alexthecat123/ArduinoFile/(threads)

Thread 1 (2023-01-06):

New build, getting a variety of errors - 84 & 75

mg-man, 2023-01-06:
Hiya, I've just built a couple of these - awesome project btw! - and seem to be running into various issues.  I've re-formatted my uSD card a few times, using both Windoze and also the SD Formatter tool.  Unfortunately, when initially trying it with the SDTemplate files, I get an 84 error - which I believe is boot blocks corruption?  When I put the uSD in my computer and overwrite the profile.image with the selector.image, the Lisa tries to boot, but then throws a "75" error - which I believe is OS files corruption?

I'm going to try some other uSD cards and also a different power setup today, but logging this here to see if it rings any bells.  I'll add more observations along the way.

mg-man, 2023-01-06:
So... switched to another PDU, another uSD card, still getting the "84" error on power-on.  Here's what's happening in the log :

`Switching to the 5MB ProFile spare table.
ArduinoFile is ready!
Phase 1: Host didn't respond with a 55! Maybe the drive was reset?
Phase 1: Host didn't respond with a 55! Maybe the drive was reset?
FFFFFF0A0000
Bad Command!
FFFFFF0A0000
4

FFFFFF0A0000
Bad Command!
FFFFFF0A0000
4

Switching to the 5MB ProFile spare table.
ArduinoFile is ready!
Resetting drive...`

The FFFF sections were spat out when booted from the Lisa OS diskette 1 and choosing [Install].  They were spat out during the 'Looking for HD' phase - which ultimately failed with 'No HD found'.

The last "Switching to" was after hitting RESET while everything powered up.  Attempt to boot gave me "84".  I then powered the Lisa off - which gave the 'Resetting drive...'

Lastly, mine is a Lisa 2/10 and works perfectly with a IDEfile on the internal connector, which I'm attempting to connect the ArduinoFile to. It also works with a real ProFile on the parallel card.

alexthecat123, 2023-01-07:
So it looks like the issue here is that the Arduino just isn't fast enough to keep up with the VIAs on the 2/10 since they're clocked faster than those on the 2/5. I'm already pushing the Arduino to its limit on the 2/5 and I guess this is just too much for it to handle. I've known about this problem for a few months now and I thought that I updated the readme to let people know before they build one, but it looks like I never updated it. I'm really sorry about this and I've updated the readme now! And of course, feel free to mess around with the sections of the code that deal with reading /STRB pulses and reading or writing the corresponding data on the bus to see if you can optimise it any more than I could. I'm not a professional software developer or anything, so there's almost certainly some more optimizations that can be done!

mg-man, 2023-01-07:
Thanks for getting back... but that is a really bummer!  I suppose the upside is it saves me wasting too much time trying to make it work.  I was kind of surprised to be the first to open an issue, so I guess there aren't too many of these out in the wild?

Please don't feel too bad, all is not lost... I'm actually working with a friend on restoring about 6 Lisas.  Only one is a 2/10 like mine, the rest are 2/5s.  Question on the 2/10, is it only when using the internal "Widget" connector that we run into this?  I do have a Parallel Card I can try... (hmm... given the time difference between us, I might have the answer as I'm going to try)  I've already build up 2 shields and have parts for a few more, so can do some experimenting and report back.

As for tweaking the code.... while I have s/w engineering skills, they're pretty dated - ASM86, Fortran [77!], Pascal, etc... I have dabbled in some PHP and Python, but only enough to be dangerous!  Do you think it'd be worth mentioning on LisaList to see if anyone out there wants to have a crack at it?

Lastly, I have poked around the 'web to see if there's a "faster" Mega 2560.  I've found the Arduino Due, but that seems limited to 3.3V output - which probably won't work?  I've also seen mention of the Hitex ShieldBuddyTC275, but that looks pricey and appears to use a different tool chain?  And, then there's the Adafruit Grand Central M4 Express... but that too is 3.3V logic.  Any thoughts?

mg-man, 2023-01-07:
Another thought... I found mention of changing the clock crystal to 20Mhz, along with MCUdude's https://github.com/MCUdude/MegaCore...  Question, assuming I manage to do this, is it likely to work or do you have timing loops that assume the standard 16Mhz clock?

alexthecat123, 2023-01-07:
Yeah, I don't think very many people have made one of these out in the wild; there's only one other person that I know of besides you who's actually built one.

Good luck with your Lisa restoration project; six Lisas is a lot to work with! Unfortunately, I just tested the device with a parallel card and it doesn't work there either because the parallel card VIAs are clocked faster than those 2/5 I/O board as well.

I thought about using the Due or another 3.3V Arduino-compatible board, but the 3.3V logic issue makes that a little bit complicated. My goal with this project was to make everything as cheap and simple as possible and the addition of an expensive Due and the complexity of level shifters (many of which are SMD components, which I would prefer to avoid) make the project stray away from this goal. If worst comes to worst, I might try to switch to a Due or something, but it would definitely be less than optimal.

The 20MHz overclock sounds like a really good idea! I'm not sure if it'll be enough to fix things, but it's definitely worth a try! There aren't any timing loops in the code that are tied to a particular clock frequency, so things should work without any modifications after switching to the new crystal.

I'm about to go back to college for the spring semester, so I probably won't have much time to work on any of this for a little while, but feel free to give it a try yourself and see what happens!

mg-man, 2023-01-07:
> _I just tested the device with a parallel card and it doesn't work there either_

Darn it!

> _I thought about using the Due ... but the 3.3V logic issue makes that a little bit complicated._

Yeah... I suspected that.

> _The 20MHz overclock sounds like a really good idea! ... There aren't any timing loops in the code that are tied to a particular clock frequency_

Good to know.  I might try this.  I have 3 x Megas, so I can use one as a "test subject".

Good luck with College.  I'll let you know how I get on.

mg-man, 2023-01-18:
SO... an update.  After a few failed attempts at using a faster ceramic resonator, I've managed to over-clock my Mega using a discrete crystal + 22pF caps...

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

Used CoreMark [https://github.com/PaulStoffregen/CoreMark](url) to confirm the 25% bump.  :-)

Unfortunately... I still haven't gotten it working.  Here's the log (I added the "/*" remarks) from a couple of tries :

`First attempt
--------------------------------------------------------------------
/* power on ArduinoFILE
Switching to the 10MB ProFile spare table.
ArduinoFile is ready!
/* power on Lisa
Phase 1: Host didn't respond with a 55! Maybe the drive was reset?
/* Lisa tries to boot
Phase 1: Host didn't respond with a 55! Maybe the drive was reset?
00000A000000
/* press Opt-3, Opt-1 to boot from internal drive
Phase 1: Host didn't respond with a 55! Maybe the drive was reset?
Phase 1: Host didn't respond with a 55! Maybe the drive was reset?
00000A000000
/* power off Lisa
Resetting drive...

Second attempt
--------------------------------------------------------------------
/* Lisa powered-on, hit reset on ArduinoFILE
Switching to the 10MB ProFile spare table.
ArduinoFile is ready!
/* hit Opt-3 to get to Lisa boot menu
Phase 1: Host didn't respond with a 55! Maybe the drive was reset?
/* hit reset on ArduinoFILE
Switching to the 10MB ProFile spare table.
ArduinoFile is ready!
/* hit Opt-1 to boot from internal drive
Phase 1: Host didn't respond with a 55! Maybe the drive was reset?
00000A000000
`
As you can see, I'm still getting the "55" error, but what's spat out after is different.  I'm now getting a "00000A000000" whereas before I was getting "FFFFFF0A0000".

Any thoughts?

mg-man, 2023-01-18:
> So it looks like the issue here is that the Arduino just isn't fast enough to keep up with the VIAs on the 2/10 since they're clocked faster

Out of curiosity... _how_ much faster are they clocked?

alexthecat123, 2023-01-18:
Sorry to hear that things still aren't working! The "host didn't repsond with a 55" error isn't really an error in this situation, so we can pretty much just ignore it. The Lisa checks for a ProFile's presence when you enter the boot menu by starting (but not finishing) the handshake and it does the same thing again when you actually tell it to boot from the drive, hence these errors saying that the Lisa never responded with a 55 to complete the handshake. Those errors would be problematic if you were getting them all the time after successfully starting the boot process, but they're to be expected here.

Unfortunately, I don't think that the change from FFFFFF to 000000 really means too much. It seems to show that the ArduinoFile is running a little faster and reading different incorrect data now, but it's definitely still reading an incorrect command. The "0A" byte should be the second to last byte in the command, but it's third to last instead, so the ArduinoFile is definitely still missing some stobe pulses. As far as I know, we can't overclock the ATmega2560 any more than this, so we're kind of stuck. The only options are switching to a faster (and preferably still 5V-tolerant so that we don't have to add level shifters) MCU or optimizing the code to make sure that we read all of the strobe pulses. I spent hours and hours on that section of the code when first creating this thing, so I'm not sure how much more optimized we could make it. I think I also configured the ATmega at some point to send us an interrupt on each strobe pulse so that we don't have to keep polling the strobe, but this was slower than the current solution from what I remember. Maybe I could try rewriting it in assembly or something? I think that's the only thing I haven't tried yet!

The VIAs in the 2/5 are clocked at around 500kHz, while the VIAs in the 2/10 are clocked at 1.25MHz. So it's a pretty significant difference!

mg-man, 2023-01-18:
> The VIAs in the 2/5 are clocked at around 500kHz, while the VIAs in the 2/10 are clocked at 1.25MHz. So it's a pretty significant difference!

Yah, it is!  More than a 25% speed bump is gonna compensate for.  :-(

This may be a complete red herring... but when Googl'ing how the PINL command works, I found this reference to the way it behaves on the Mega ...
[https://forum.arduino.cc/t/arduino-coding-without-delays-using-program-ticks/196693/17](url)

alexthecat123, 2023-01-20:
That's really interesting! I had no idea that some of the I/O registers required more CPU time to access than others! I wonder if it's a big enough difference to solve our problem? I'm super busy with college right now (this semester has been the busiest one so far), so I'm not sure when I'll get around to switching to different ports and trying things again, but I'll definitely let you know if/when I get around to it! And of course, feel free to give it a shot yourself if you're in a hurry to get things working!

mg-man, 2023-01-20:
I'm glad that wasn't a total herring!!  Unfortunately, I'm not sure I have the knowledge / skill to investigate a change.  :-(  Will switching to a different port be purely software, or would hardware mods be needed?  If software, I'm willing to have a crack if you'll point me in the right direction.  ;-)

There's no massive rush, it'd just be nice to have a solid-state alternative to my failed Widget.  Get back to me when you can and good luck with college!

alexthecat123, 2023-01-20:
Sadly, it's a little more than just software. The ports are implemented in hardware, so a certain set of 8 Arduino pins connect to each port. Changing the port would require rewiring the data bus to a different set of pins that correspond to another port. The software side is really easy, though. Let's say that we're going to change the bus from port L to port A. All we would have to do is replace all instances of PORTL with PORTA, PINL with PINA, and DDRL with DDRA. The port for the control signals is already one of the "fast" ports (port C), so we can just leave that one alone! Looking at the ATmega2560 datasheet, it seems that all ports under address 0x60 (meaning ports A-G) can be accessed quickly, so changing to any of these (other than C since it's already used) would be fine.

mg-man, 2023-01-20:
> Sadly, it's a little more than just software.
Darn it!!  ...but I kinda figured.

> Changing the port would require rewiring the data bus to a different set of pins that correspond to another port.
So that's 8 x "cuts" and 8 x "bodge wires"?  Won't be pretty, but doesn't seem impossible.  I had 5 x 'boards made up, and have so far only built up 2, so I'm happy to hack at one of them if you can point me in the right direction?  Do you want to create a Lisa 2/10 branch and we'll get started?

alexthecat123, 2023-01-21:
I just created a 2/10 branch and added you as a contributer so that you can update things with any changes that you might make. And yep, it's 8 cuts and 8 bodges. Not super fun, but it could definitely be way worse (flashbacks to the 70 or so bodges that I had to do on my VERY damaged 2/5 I/O board)! Thanks for offering to give these mods a shot; I've been really stressed with school and this defintely relieves some of that stress!

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

There's an image showing you the different ports on the Arduino Mega. You can probably see why I went with ports C and L; all of the pins for the port are clustered together instead of being scattered all over the place! I'm not sure why I went with C and L instead of C and A, but we can't use A anymore because that's where I hooked up the status LED and it would be easier if we didn't have to mess with that. Looking at the image, it seems like port B or F would be the way to go; the other ports are either in that extended I/O space that slows down access or not all of their pins are exposed on the Arduino. B would probably be the best choice since keeping F free would be nice in case we ever decide to use analog inputs or outputs in the future, but it's totally up to you! Let me know which port you choose and I'll go through and change the code accordingly so that you can focus more on the hardware.

Rewiring everything should be pretty simple; tedious but simple. Just connect PD0 to pin 0 of the port, PD1 to pin 1 of the port, and so on up to PD7.

When cutting the traces, make sure to cut them between the Arduino and LS280 parity generator, not between the parity generator and the 26-pin ProFile connector! We need to keep the LS280 connected to the data bus, and cutting it out of the circuit would screw things up. From what I remember when I first made this thing a year ago, MacWorks would still work since it doesn't care about parity, but LOS would not be happy!

mg-man, 2023-01-21:
> I just created a 2/10 branch and added you as a contributer so that you can update things with any changes that you might make.

Cool, thanks!

> Thanks for offering to give these mods a shot; I've been really stressed with school and this defintely relieves some of that stress!

Well don't stress about this!!!  I have a pretty demanding job, so I have to dip in and out of this as well.  If I sound a little annoyed at times, it's a) probably work-related ;-) or b) just really wanting to figure out how to make this to work.  I could not have possibly done what you've done myself, so I'm grateful you did and eager to see if we can created a 2/10 compatible implementation!  :-)

> There's an image showing you the different ports on the Arduino Mega.

Thanks for that!  I did a bit of Googl'ing, but always landed on much more complicated diagrams - this one is much clearer for what we need (find another - hopefully faster - port).

> we can't use A anymore because that's where I hooked up the status LED

Glad you said that.  On the 'complicated' ones I did find, I compared them to my boards and it did look like Port A was in use (and connected to the LEDs), so I was a little confused given your initial comment about Port A vs L above.  This clears it up and also confirms I'm looking at the right things on my board.  :-)  If we DO get this working, maybe you can move the LED control to Port D for example - which appears to be in proximity to the LED placement, meaning A could be re-purposed.  Maybe that will make the routing simpler like it was for Port L?  Let's see if I can get it working first tho.  :-)

> Let me know which port you choose

Will do.  I'll work out where the connections to Port L come and go and then which alternate Port to aim for.  Tell me something, though... looking at the image above, I can only see 5 pins for Ports D & E, 4 pins for Port G?  Am I reading this correctly?  If so (and assuming we need 8 pins = byte-wide), that means our choices are B or F only.  I'll go for B as you suggested, but let me know if I have this right.

> When cutting the traces, make sure to cut them between the Arduino and LS280 parity generator

Hee, hee... I did spot some were going to the LS280, so wondered about that - thanks for the clarity!

It might be a day or three before I get stuck into this, so focus on your studies and enjoy the weekend!

mg-man, 2023-01-21:
> Just connect PD0 to pin 0 of the port, PD1 to pin 1 of the port, and so on

SO... re-reading this.  Am I correct that all I need to do is locate the traces that go from PDx to Port L and sever / replace those?  If so, I didn't solder in the Debug Header, so this might not end up too ugly of a bodge!  LMK

mg-man, 2023-01-22:
> B would probably be the best choice since keeping F free would be nice in case we ever decide to use analog inputs or outputs in the future

Well... I sat down to have a look at this and discovered an issue with using Port B.  From looking at the board (and schematic) it looks like a few of the pins on Port B are used for the uSD card adapter.  :-/  Can you confirm?

As for Port F, it's marked as "ANALOG IN" but you mention it above, so it _can_ be used for 'digital' (logic) as well?

Lastly... I've realised I can modify one of my boards without making ANY cuts.  All I need to do is omit pins 42 - 49 of the header, and then wire PD0 - PD7 to the Port F pins - right?

alexthecat123, 2023-01-22:
To answer your question about certain ports only having a couple pins, it's because they didn't wire every pin on the ATmega2560 to a pin on the Arduino. I'm not sure why they did this (maybe they didn't have enough space to do all of them), but this is why some of the ports only have a few of their pins exposed.

Darn, you're totally correct about the SD card! Clearly I didn't look at the schematic very closely, lol. So I guess port F is our only option. And yeah, the analog pins can be used as both analog and digital pins, so we should be good to go there!

And that's a really clever way of rewiring things! I didn't even think of that as a possibility, but it's definitely the smartest way to do this! Just make sure that PD0 goes to pin 0 of the port, PD1 goes to pin 1 of the port, and so on. Otherwise, we would have to do some painful modifications to the code that would probably slow things down to the point that it wouldn't even work on the 2/5!

I changed the code in the 2/10 branch to reflect the change to port F, so you can just upload that to the Arduino whenever you're ready to test things!

Good luck and let me know how it goes!

mg-man, 2023-01-22:
Thanks for getting back on all that.  Glad I'm able to make some sense of this.  😀  I'd already decided to embark on using PORTF.

After a false start which ended up being a bad microSD adapter, I managed to get the modded on built.  Here are some pics:

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

Moment of truth... attached it to a standard Mega, got the 84... drat!!  So... tried it with my go-faster Mega... and...

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

Woo woo!!!  But... I'm not sure why it isn't seeing any of the images I have on the SD card - there are two, and I know they work on my IDEFile and one of ArcaneByte's BeagleBoard-based ProFile emulators.  Any ideas?

alexthecat123, 2023-01-22:
WHAT? It actually worked? I honestly wasn't expecting that, but that's so awesome! Great work! As for the error message that you're seeing there, I get that occasionally too, even when using a real Cameo/Aphid. I have no idea what causes it, but you should be able to get past it by choosing the B(oot option. If that doesn't work, try the S(tart over option, and if that still doesn't work, try Q(uitting to ROM and then booting from the ArduinoFile again.

It's definitely able to read the contents of the SD card because the emulator would halt itself and turn the LED red if it didn't detect an SD card. Also, you wouldn't be seeing that message if it wasn't able to boot from the Selector image, so I'm pretty confident that there isn't anything seriously wrong and that following the instructions above will fix things!

It kind of sucks that the overclock is still necessary to get things working, but at least it isn't a particularly difficult mod or anything. And the mod only needs to be done if you're using a 2/10, which seems to be a minority compared to 2/5 users, so I guess it's not too bad!

By the way, those are some really nice and clean bodge wires! And I love the black color of your board too; I'll definitely be ordering my next batch of boards in black!

mg-man, 2023-01-22:
> WHAT? It actually worked?

Well.... not quite it seems.  I did try S)tart and B)oot but it kept coming back to the same screen.  I then decided to just rename one of my LOS images to be profile.image - and it started to boot... then emitted a medium tone and threw be back to the Startup From... screen (with the tone still on).  I tried another boot and this time it cleared the tone, but crapped out with a 10707 error.

I then decided to try and Repair the HD... no joy.  So I then tried to just Install LOS.  It 'sees' the HD and asked if I wanted to Erase, so I did.  After a L O N G wait (with the Status LED flickering away) it barfed with the following :

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

I didn't have my laptop connected to the serial output, so tried another Erase - here's the top and tail of the log :

/* Lisa powered-on, hit reset on ArduinoFILE

Switching to the 10MB ProFile spare table.
ArduinoFile is ready!

/* Booted from LOS Install Disk 1 and chose "Install"

Phase 1: Host didn't respond with a 55! Maybe the drive was reset?
Phase 1: Host didn't respond with a 55! Maybe the drive was reset?
Phase 1: Host didn't respond with a 55! Maybe the drive was reset?
000000000A03
00FFFFFF0A03
0000000D0A03
000000020A03
000000070A03
0000000C0A03
000000010A03
000000060A03
0000000B0A03

------

0100002D0A03
010000220A03
010000270A03
00FFFFFF0A00
0000002E0A03
0000002E0A03
0000002E0A03
0000002E0A03
0000002E0A03

So, as they say, "close, but no cigar"

Been a long day... I might try with a 5Mb ProFile image tomorrow.  Also... I have some 74HCT280s on order - just to try.

Let me know if there's anything else you can think of.

alexthecat123, 2023-01-23:
Well darn. Never celebrate too early I guess. That output is identical to what I get when I do an install on a 2/5, so it looks like it's receiving all of the command bytes properly now. I remember LOS being very picky about timings when I was first designing this thing; believe it or not, MacWorks worked fine on the very first test I ever did, but the Office System took a couple weeks of work to figure out. I wish I remembered exactly what timings it was unhappy with....

To go any further, we probably need to look at a logic analyzer trace. I'm not sure if you have a logic analyzer, so this might be the point where I need to just build the updated version and mess around with it myself. I'll try to design an updated PCB (and clean up that monstrosity of a schematic that I drew when I was still new to PCB design) as soon as I can and then I'll see if I can figure things out. Unless, of course, you have a logic analyzer and want to try it yourself. I wish I wasn't so darn busy with school right now!

I doubt that the HCT280s will fix things since the original ProFiles themselves used LS280s, but it's definitely worth a shot! I also didn't think that switching to port F would make this much of a difference though, so what do I know?

Maybe give it a shot with MacWorks and see what happens there. If it works okay, then that sort of confirms our theory that it's a LOS-specific issue.

mg-man, 2023-01-23:
> Well darn. Never celebrate too early I guess.

Yeah... but I consider a step forward.  Small victory, but the war is still to be won.  😀

> That output is identical to what I get when I do an install on a 2/5

Interesting... including the Stop Sign fail?  Maybe you're on the edge with timing on the 2/5, and I'm now getting to the same point with the 2/10?  🤔  In addition to the HCT280s, I'm debating on boosting another of my 2560s to 22.1184 MHz - which is a better match for serial port speed conversion.  It will mean I need to build my own bootloader - or use a USBasp (which I'd need to get), hence the debating...

Something else I found that may be worth a go is this - https://forum.arduino.cc/t/digitalwritefast-digitalreadfast-pinmodefast-etc/47037 - any thoughts?

> To go any further, we probably need to look at a logic analyzer trace

Yeah... I figured we might be on that path.  Sadly, I don't have one.  It's also a shame we're on opposite sides of the ocean - making sending you one of my boards cost-prohibitive.  😞

Thanks for sharing your experiences, it sounds like we're heading in the right direction and maybe some of the above will get us there.  I'll start with the HCT280s, then attempt another clock boost, and will give MacWorks a spin.  LMK what you think about those DigitalFast routines.

alexthecat123, 2023-01-23:
> Yeah... but I consider a step forward. Small victory, but the war is still to be won. 😀
I guess you're right! It's definitely working better than it was, so we're taking some steps in the right direction!

When I said that I got the same output on the 2/5, I was referring to the ArduinoFile debug stuff over serial, not the error message. It would've been really bad if I got that error message on the 2/5 as well! What I was trying to say is that it's clear that we're properly receiving the command bytes now because they perfectly match the command bytes from a successful install on my 2/5.

I had no idea that you could overclock the Mega past 20 MHz, so it'll be really neat to see what happens if you bump the clock speed up a little bit higher! Assuming it's not too much of a pain for you, I'd say go for it! We're clearly pretty close to getting it to work and that additional 2 MHz might be enough to do it!

I just took a look at that forum post and unfortunately that won't really help us here. That library is basically providing a wrapper over direct port manipulation that's way faster than the default digitalRead and digitalWrite, but still slower than direct port manipulation. But unfortunately we're already manipulating the ports directly. That's what all of the weird code like "PORTF = 00001111" is for; we're directly writing values to the port registers to maximize speed instead of using more programmer-friendly functions like digitalWrite or the digitalWriteFast that you linked to. Plus, writing an entire byte to the parallel bus is much quicker and easier with direct port manipulation since you can set all 8 bits with one line of code instead of having to do a bunch of digitalWrites in a row. So good idea, but unfortunately it would slow things down.

Since you don't have a logic analyzer, I'll just design some new boards and get them ordered as soon as I have time. I would just modify one of my existing ones, but it's probably better to go ahead and order some with the new design. I'll have to do a redesign eventually, so might as well go ahead and do it now!

Good luck with the HCT280, clock speed, and MacWorks experimentation!

mg-man, 2023-01-24:
> When I said that I got the same output on the 2/5, I was referring to the ArduinoFile debug stuff

Thanks for clarifying. So you "have" been able to Erase/Install LOS, goos to know it _should_ work.

> So good idea, but unfortunately it would slow things down.

No worries... I'm pretty sure I spotted at least one DigitalWrite in the code, but no DigitalReads.  On further inspection, looks like you're only using it in the setup section and for the LED.

> I had no idea that you could overclock the Mega past 20 MHz

😀  When researching this... I saw mention of ppl claiming 30Mhz works!  I'll try 22.1184  since I do
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

Thread 2 (2023-10-24):

R/W errors in MacWorks and error 1070 in LisaOS

RolandJuno, 2023-10-24:
Background: I have a Lisa 2/5 system that consists of a original CPU and SunRem 2MB cards as well as reproduction motherboard and I/O cards. I'm also using EPROMs as emulated PROMs on the CPU and I/O cards as well as a COP emulator on the I/O card.

Reads from the ArduinoFile seem solid. I've not encountered issues there. The issue seems to be with writes to the device. The symptoms while using the ArduinoFile are:

- MacWorks will report **"The file "name" couldn't be written and was skipped (disk error)."** while copying a large-ish file (one that typically takes multiple read/write cycles in the Finder).
- When I try to boot into the LisaOS, I get an error 10707.

First I tried the following:

- Monitored the serial port for debug messages. When the error in MacWorks appeared, the debug statement **"Phase 1: Host didn't respond with a 55! Maybe the drive was reset?"** appeared.
- Set the timeout value from 10000 to 20000. MacWorks still produced the error but there was no error messages on serial this time.
- Changed the version of SDfat to an earlier version (2.0.5 is pictured in the docs but that wouldn't compile. 2.1.0 was the oldest that would compile).
- Removing the Serial.println statements in an attempt to speed things up

I then found this issue thread which seemed to offer some hope! I tried the following:

- Set the compiler flag to -Ofast.
- Bodged the board to use PORTF instead of PORTL.

None of these so far has resolved the issue in MacWorks. I'm hoping that someone has some ideas of what might be the issue?

Update: I enabled many of the serial debug statements in the code and watched the stream. It seems the Mac will write data and then read it back to verify. I got a new error this time.

- Timeout: Read Command Confirmation
- Phase 1: Host didn't respond with a 55! Maybe the drive was reset?

PS Alex, I know you're very busy so reply only if time allows! Your university studies should be your top priority! =-)

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

_Originally posted by @RolandJuno in https://github.com/alexthecat123/ArduinoFile/issues/1#issuecomment-1777440929_

RolandJuno, 2023-10-24:
I'm using the fork located at https://github.com/alexthecat123/ArduinoFile/tree/2/10-Testing

The CPU card is an original. Unfortunately, I don't have access to any other I/O cards. I'm using H ROMs on the CPU card.

The quartz clock on the CPU card are original. The ones on the I/O board are to spec.

I have been curious about the 6522 as being suspect. I have some extras I can try plus the modern WDC W65C22N6TPG (which I couldn't get to work originally but are supposedly drop-in replacements for the original 6522). Will give this a try.

I've tried three different class 10 SD cards (SanDisk, Samsung and PNY).

Also, as before, I increased the timeout value to 15000 this time and both errors in the serial debug stream went away but the error on MW II+ still persist (but definitely seem to be related to reading back what was just written).

Is there a way to write to the debug stream the actual data in HEX that is being read and written? That could help me pinpoint if it's an actual verify error or a timing error.

RolandJuno, 2023-10-24:
I just tried three different 6522 chips in U5C. A SY6522A, MOS6522, and a new W65C22N6TPG. All three produce errors from the ArduinoFile.

`Timeout: Write Command Second Handshake Part 2
Phase 1: Host didn't respond with a 55! Maybe the drive was reset?

Timeout: Read Command Confirmation
Phase 1: Host didn't respond with a 55! Maybe the drive was reset?

Timeout: Write Command Confirmation
Phase 1: Host didn't respond with a 55! Maybe the drive was reset?
`

Does this seem to show that we're missing a signal (or never get one)?

RolandJuno, 2023-10-24:
I connected my logic analyzer to the pins pictured in the screenshot (6 control lines and 2 data lines). I attempted to copy a large application in MW II+. It produced a write error on the Mac side. The last few lines of the debug from the ArduinoFile are:

..
010034F7030A
010034FC030A
010034F1030A
010034F6030A
010034FB030A
01003500030A
01003505030A
0100350A030A
0100350F030A
01003504030A
01003509030A
Timeout: Write Command Confirmation
Phase 1: Host didn't respond with a 55! Maybe the drive was reset?

The logic analyzer was stopped shortly thereafter with this near the end of the capture.
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

Zooming in:
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

Hopefully this helps? Let me know if you want the raw data or more screenshots or measurements.

mg-man, 2023-10-24:
> _I'm using H ROMs on the CPU card._

Can you use H ROMs on a 2/5 I/O board?  I thought H ROMs were for the 2/10?

RolandJuno, 2023-10-24:
Yes, H it works with a 2/5 system. H/A8 is the combination I have.

> Common/Recommended combinations:
>
>    H/A8 - Typical for a Lisa 2 or 2/5

Source: https://lisafaq.sunder.net/lisafaq-hw-rom_versions.html

mg-man, 2023-10-24:
Fair enough, I knew there was a diff between the 2/5 & 2/10... but that's the A8 vs 88 - mine's [2/10] the latter.

RolandJuno, 2023-10-24:
I get further in the MW II+ copy by changing timeout in ArduinoFile to uint32_t and increasing it x10 to 100000. It seems to fail at the end with a "disk error" now rather than a write error.

I decided to run Disk First Aid and it reports it's not an HFS disk. ArduinoFile produces an error:

> 0000FFE1030A
> Error: Requested block is out of range!
> 0000018C030A

Maybe that's expected behavior? @mg-man Can you successfully use Disk First Aid with your ArduinoFile?

mg-man, 2023-10-24:
I'm the one who started the Issue #1 thread, and tried over-clocking my Mega and also the Port F mod.  I was never able to get my ArduinoFile to fully boot as my Lisa is a 2/10.  I've not had a chance to try these latest mods, but am excited to do so.  Will have to wait, though, on vacation with family atm.

RolandJuno, 2023-10-24:
Your detailed posts and tenacity are what drove me to dive deeper into this issue I'm having-- thank you for that! Enjoy your holiday!

mg-man, 2023-10-24:
Thx.  I'm pretty excited to try @i-to-z's compile flag as soon as I can find some time. I'm also restoring a 2/5 which I want one of these for as well!

mg-man, 2023-10-24:
Out of curiosity, have you tried another LS280?

RolandJuno, 2023-10-24:
Lots of progress just made. I noticed that when I gave it a really long timeout, the second error "Phase 1: Host didn't respond with a 55! Maybe the drive was reset?" didn't appear anymore. Additionally, the system wouldn't boot properly into the drive selector mode for aphid/cameo (it just hung and the green light never came on).

I decided to keep timeout at 10x (100,000). I created a secondary timeout for all those loops called phaseTimeout and set it to the original (10,000).

> uint16_t phaseTimeout = 10000; //around 18ms
> uint32_t timeout = 100000;
...
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

I also decided to start from scratch. I created a new harddrive image and booted from a MW II+ floppy. I chose the internal Profile in the installer and clicked install. It began by formatting the drive. The ArduinoFile began reporting sequential block writes as expected. I also noticed this took **a lot longer** than it did in previous attempts (I wasn't monitoring the serial debug stream at that point however so it very well could have had an error there).

Curiously, when it got to block 80000, it began reporting "Error: Request block out of range!"

```
...
01007FF2030A
01007FF7030A
01007FFC030A
01007FF1030A
01007FF6030A
01007FFB030A
01008000030A
Error: Requested block is out of range!
01008005030A
Error: Requested block is out of range!
0100800A030A
Error: Requested block is out of range!
0100800F030A
Error: Requested block is out of range!
01008004030A
...
```

Despite this I let it roll. It eventually successfully installed everything. First real test was to copy a System Folder over to it, which worked the first time. I rebooted and proceeded to install System 6.0.8 which worked without issue. I rebooted and copied over Photoshop 1.0 which also worked!

So far, that may have solved the issue! I'll continue testing to be sure and will report here.

i-to-z, 2023-10-25:
[RolandJuno](https://github.com/RolandJuno),
I haven't tried running MacWorks+ on a Lisa. I want to try it too.
Which of the many versions listed here are you using?
https://www.macintoshrepository.org/apple-lisa/software_search.php?s=macworks

Also: have you tried less-demanding operating systems on your Lisa, like MacWorksXL3.0 ? Since it works well for most of us, it may be a good validation for you that your hardware is solid.

Regarding the "Error: Requested block is out of range!" error: Perhaps you should try installing MW+ on a larger blank image file?

RolandJuno, 2023-10-25:
Thanks for the reply! I chose a disk image size of 32MB which I believe is supported with MacWorks. I hope that the installer was able to read the size of the disk before attempting to format it.

In any case, the ArduinoFile now has been working flawlessly all night. I've been installing a lot of software and docs on it without a single disk read/write error. It's amazing that AppleTalk works with it too-- I'm able to connect to my RaspberryPi running MacIPGW via a EtherTalk to LocalTalk adapter.

Tomorrow I hope to try the LisaOS again to see if it clears up the 10707 error I was getting.

jake18125, 2023-10-25:
@RolandJuno That's brilliant! Do you think that fix would work with a stock ArduinoFile without the PORTF mod?

Also any chance you could share the complete .ino file? Thanks!

Thread 4 (2023-11-26):

SD card footprint mirrored?

RolandJuno, 2023-11-26:
I ordered some boards of the ArduinoFile 1.1 gerbers (labeled v4 on the schematic-- with P0-7 pins mapped to A0-A7) and noticed the SD card pinout might be reversed from the original. The SD card reader needs to be installed up sidedown.

Edit: I also think the pin mapping for the LED needs to be changed as below.

```
const int red = 41; // was 22
const int green = 40; // was 23
const int blue = 39;  // 24
```

```
  //pinMode(22, OUTPUT); // old pin assignments
  //pinMode(23, OUTPUT);
  //pinMode(24, OUTPUT);
  pinMode(red, OUTPUT); // new pin assignments
  pinMode(green, OUTPUT);
  pinMode(blue, OUTPUT);
```

With these changes, the ArduinoFile boards seem to be functional! Cheers!

i-to-z, 2023-11-28:
Interesting.
I just received today 5 new boards from JLpcb and did a continuity test with a multimeter.
I confirm that @RolandJuno is correct about the SD card and the LED.

I personally welcome the SD card change because the SD card adapters that I bught have pins soldered on the side of the card holder; for the older board I had to desolder them to move them to the other side, now I don't have to.

alexthecat123, 2023-11-29:
Yeah, you're totally right about the SD card and LED issues! I guess that's what I get for making modifications to the PCB without actually ordering and testing them. Sorry about all that! I've updated the PCB to fix the SD card issue as well as the code to fix the LED issue, so we should be good to go now!

Closed 2023-11-29.

Thread 5 (2023-11-29):

Apple Parallel Expansion Card support ArduinoFile?

RolandJuno, 2023-11-29:
I'm trying out the ArduinoFile with a new Apple Parallel port Expansion card that I built. The card is recognized by the system in slot 1 as I get additional "boot from" icons for upper and lower ports (cmd-4 and cmd-5). When I select the ArduioFile port, I get an error 85 with the following messages on the serial debug.

```
Switching to the 5MB ProFile spare table.
ArduinoFile is ready!
Phase 1: Host didn't respond with a 55! Maybe the drive was reset?
Phase 1: Host didn't respond with a 55! Maybe the drive was reset?
000000000A03
Read phase 2: Host didn't respond with a 55! Maybe the drive was reset?
```

Tried with the revised A0-A7 PORTF change as well as the compiler -Os to -Ofast change with no difference.

Any ideas what could be wrong?

i-to-z, 2023-11-29:
@RolandJuno , what OS are you trying to boot?

Note that some Lisa operating systems, e.g.  MacWorksXL3.0, work only with the built-in parallel port. This is evident during the installation process from floppies.

Others, like Lisa OfficeSystem, do work with the expansion port, but a profile.image made on the internal port may not boot when using it on the external port.

It's best to start with a blank profile.image file and install your OS from floppies.

alexthecat123, 2023-11-29:
Strange! The Selector is absolutely supposed to work with parallel cards (it works great on my Lisas), so something is clearly not right here. Can you test your parallel card with an actual ProFile (or another emulator like Cameo/Aphid) to see if it's a bad parallel card or an ArduinoFile issue? And I'm guessing that you've already tried this, but you could also move the ArduinoFile to the other port on the card to see if that changes anything!

aurel6814, 2025-01-20:
First thing, Thank you Alex for your work. I have a Lisa 2/10 and it seems to work properly with the PortF modification. I made the arduinofile a few years ago but I thought I had a problem with the I/O card because my profile and widget were also not working....
I had the same problem as RolandJuno on my external parallel card.
Don't wait 1ms before disabling interrupts (line 205) seems to fix my problem and I am able to boot on the Selector from the external port.

alexthecat123, 2025-01-20:
I'm really glad to hear that, and I'm glad that you've been
enjoying ArduinoFile over the past couple years! Keep in mind that I've
still had a few issues using ArduinoFile on Lisa 2/10s and with parallel
cards, even after making some of the appropriate mods, so you might still
see some weird behavior and corruption occasionally. The Lisa is pushing
right up against the limits of what an Arduino can handle, so results can
be pretty unpredictable.

Stay tuned, because I'm going to be releasing a much-improved successor to
ArduinoFile in just a few days, and it fixes all of these reliability
problems entirely!

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

alexthecat123, 2025-01-21:
Well, I was actually able to get ESProFile finished up today. So feel free to go and [check it out](https://github.com/alexthecat123/ESProFile)!

Thread 6 (2024-07-25):

Drive formats and can backup a 5MB profile but wont boot

Gary-Clark, 2024-07-25:
Hi

Not sure if your still actively supporting this but

I can connect the device to the parallel port of our Lisa, and format the image from the OS, back up a 5mb profile HD to it and all the files are there. I can read and write to the drive fine

However, it wont boot.

When I try to boot I get the

000000000A03
2
Read phase 2: Host didn't respond with a 55! Maybe the drive was reset?

Any ideas ?

alexthecat123, 2024-07-25:
Hi Gary,

Sorry you're having issues!

Two questions. First, what model of Lisa are you using? I'm assuming you're using a Lisa 1 or 2/5 based on the 5MB ProFile comment, but I just want to double-check that! Second, are you hooking the ArduinoFile to the built-in parallel port or to a port on a 2-port parallel card? There has been some ArduinoFile weirdness with parallel cards and with the 2/10, so let's try and rule that stuff out first. But the fact that you say the OS can read/write to the drive just fine seems to point to something else.

Are you trying to run LOS or some other operating system? If you're running LOS, then the procedure you seem to be describing of formatting the drive, copying all of the files over, and then rebooting the machine won't result in a bootable volume, so that could definitely explain things too. If this ends up being the problem and you don't feel like installing the OS from floppies yourself, I can provide a pre-installed bootable LOS image that you can just throw on your SD card and try out.

I hope we can get to the bottom of this!
Alex

Gary-Clark, 2024-07-26:
Hi, thanks for responding

Its a Lisa 2/5 with the single floppy and a 5MB profile and the emulator drive is plugged into the inbuilt parallel port.

I did wonder if I needed to do an install from the floppies but unfortunately the floppy drive is defective. I used the duplicate option from the Lisa OS to backup the drive but wasn't sure if that would make a bootable image.

Its a museum display machine and the Profile drive is making a lot of noise so I am wanting to make sure I have a booting drive if/when it fails but we want it to boot just like an original machine rather than use the selector.

A pre-installed version would be great :)

alexthecat123, 2024-07-26:
Yeah, that's almost certainly the problem! Duplicating the contents of the hard drive won't copy the system files over, so your new disk won't boot.

Do you want an image of LOS 2 or LOS 3? Or both? Don't worry, the LOS applications will work just fine on your Lisa despite our differing Lisa serial numbers because I wrote a program that disables the serialization check on all the LOS apps!

Gary-Clark, 2024-07-29:
Both sounds ideal, cheers

I do need to fix the floppy, but its one of may jobs.

alexthecat123, 2024-07-31:
Sorry for the delay in getting back to you! My ArduinoFile SD card with all of my images somehow got corrupted, and I lost everything on it. Luckily, I had a backup of most stuff, but not the two images that I was going to send you since I made them fairly recently and hadn't backed them up yet. So I had to pull out a Lisa yesterday and remake them from scratch.

But I finally got them recreated, so here you go! Note that LOS 2 will sometimes fail to boot on your first boot attempt with an error code for some reason; try booting again and it'll work just fine. And sometimes LOS 2 will randomly reset the system during the boot process, but the same thing is true here as well; just try again and it'll work.

For whatever reason, Github won't let me attach files with a .image file extension, so I changed the extensions of both files to .txt, which is one of the allowed filetypes. Just change them both back to .image when you download everything. And since you said you'd rather not use the Selector, rename whichever image you want to use to profile.image in order to get the ArduinoFile to recognize it at power-on.

Let me know if these work. And if so, make sure that you can create documents in all of the apps without serialization issues. If not, we've got more troubleshooting to do!

[LOS 2 - No Serialization On Apps.txt](https://github.com/user-attachments/files/16442559/LOS.2.-.No.Serialization.On.Apps.txt)
[LOS 3 - No Serialization On Apps.txt](https://github.com/user-attachments/files/16442561/LOS.3.-.No.Serialization.On.Apps.txt)

alexthecat123, 2024-07-31:
And as for fixing your floppy drive, it probably won't be too difficult. These floppy drives are the same ones that are used in the Mac, and they're pretty darn reliable. Some lubrication of the moving parts and a cleaning of the heads normally brings them back to life, although you might also have to replace the eject gear if you have the 800K drive upgrade installed in your Lisa. There are plenty of tutorials showing how to do all of this online since the drives are also used in the much more common Mac, so it really shouldn't be too bad!

Gary-Clark, 2024-07-31:
You are a star !

Perfect timing as I will test these at the Museum on Friday when I am next in (shameless plug - Northwest Computer Museum - Leigh - UK) then close the issue when they work :)

Its amazing how versatile the Mega 2560 is. I used one for my Commodore 8050 GPIB disk drive emulator but its a shame there isn't a modern and faster but still 5V version.

alexthecat123, 2024-07-31:
Awesome! I'm excited to hear how it goes. That seems like a really cool little museum; if I'm ever in the UK, I'll have to go and visit!

Make sure not to throw out the original guts of the ProFile when you install the ArduinoFile in its case! I totally understand why you want to replace it with an emulator (I've got some really loud ProFiles myself), but it would be a huge shame to lose that original hardware.

Yeah, the Mega is pretty awesome, and actually has higher I/O speeds than the ESP32 according to some of my testing! I tried porting the ArduinoFile code over to the ESP32, but its GPIO is somehow slower than the Mega, and it couldn't even keep up with the 2/5's slower VIA speeds! It would be really awesome to get a faster Mega that's still 5V-tolerant, but I'm not super optimistic that it'll ever happen.

Gary-Clark, 2024-08-02:
File downloaded and renamed profile.image, the Arduinofile started with the green LED lit and responds with

Switching to the 5MB ProFile spare table.
ArduinoFile is ready!

With it plugged into the internal parallel port, the Lisa responds with error 85 and the Arduinofile responds with

000000000A03
Read phase 2: Host didn't respond with a 55! Maybe the drive was reset?

Booting from the profile I can see the Ardinofile and open its contents.

Tried both images but same errors.

Will try to get the floppy working so I can see if I can do an install from the disks

alexthecat123, 2024-08-06:
Awesome! Whenever you get the chance, just connect your LA straight to the debug header on the ArduinoFile board and that will capture all the signals that we need to see!

Yeah, burning an 800K ROM sounds like a good idea in terms of ease of finding a replacement floppy, although keep in mind that you won't be able to mount the 800K drive in the Lisa without a special bracket.

The boot ROM doesn't have to be changed to work with an 800K drive; just the I/O board ROM has to be changed. I'd recommend replacing it with the universal 400K/800K version that I've attached, which will work with either type of drive and you'll never have to worry about it again!

Also, you might want to read [this topic on LisaList2](https://lisalist2.com/index.php/topic,494.html) so you know what to do if your drive does weird eject-related things once you get it installed.

What version of the boot ROM do you have? Come to think of it, I believe I've only tested the ArduinoFile with H and 3A ROMs, so anything earlier might cause some kind of problem. If so, we need to figure out what's going wrong and fix it!

[25SSDSM6.BIN.zip](https://github.com/user-attachments/files/16515894/25SSDSM6.BIN.zip)

Gary-Clark, 2024-08-17:
Hopefully these are the images I captured during a boot. The signals are ordered top to bottom with Parity as D0 and PD0 as D12

Haven't done any analysis myself yet due to museum activities.

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

Gary-Clark, 2024-08-17:
Pic 2 is after pic 1 and is all the activity on the cable during a boot attempt.

alexthecat123, 2024-08-17:
Interesting...

So it looks like the handshake goes smoothly and almost makes it to the end, but then gets messed up at the last minute. The drive and Lisa complete their initial handshake, the command is transferred properly (as evidenced by the 000000000A03 that you see in your terminal), and then we move onto the command confirmation phase. At this point (all seen in the second trace), the Lisa is supposed to lower CMD, and the ProFile is supposed to respond by putting [command byte + 2] on the bus, so 0x02 in this case, followed by the ProFile lowering BSY. Then the Lisa acknowledges this by putting an 0x55 on the bus and raising CMD. Once this finishes, the ProFile reads the desired block, raises BSY when done, and then the actual data transfer can begin.

But what's happening here is that CMD is being raised before the ArduinoFile responds with 0x02 and raises BSY, which means that the Lisa is aborting the transfer. So I'm thinking that the Lisa is timing out and giving up on the read because it thinks that the drive is too slow and isn't responding at all. I guess this is a property of some of the older ROM revisions, because this timeout is much longer in the revision H CPU board ROMs. This seems to be supported by some of the comments in the CPU board ROM changelog.

So I guess you have two options. First, just upgrade to H ROMs. Or second, keep your ROMs, and let's try to fix this. Personally, I think the second option is the better idea, simply because I feel that it's important for ArduinoFile to work with as many ROM revisions as possible, but it's up to you! I wish I could just do some testing here myself, but college is about to start back and I just moved into my apartment, leaving my Lisa 2/5 behind at home, so the best that I can do is send you modified source code and get you to upload it and see what happens. Does that work? Or would you prefer to just swap out the ROMs?

And the reason why the Office System works with the disk just fine is simply that LOS doesn't use the ROM's disk routines at all; it has its own completely custom access routines baked right in. And those clearly have a much longer timeout than the ROM's!

At least we've figured out the issue now!

Gary-Clark, 2024-08-17:
I will be happy to test any code you send. I agree that it would be a really good idea to get it to work on all ROM's

Thanks.

alexthecat123, 2024-08-19:
Great! Thanks for your willingness to help!

Give the two files that I've attached a try whenever you get the chance. Try Fix1 first, and then go for Fix2 after that. With Fix1, you will no longer see commands get printed over serial (although errors will still be printed), so just keep that in mind. Fix2 will still print commands, so it's the more desirable option, but it's less likely to fix the problem than Fix1.

If Fix1 ends up working, but Fix2 doesn't, then there's still a couple other things I could probably do in order to get it to print commands and still work with these older ROMs. But I don't want to put any effort into those sorts of changes until we have some data on these first two patch attempts!

Github won't let me attach files with an .ino extension, so I've changed the extensions to .txt. Just switch them back to .ino before opening things in the Arduino IDE.
[proFileEmulator_Fix2.txt](https://github.com/user-attachments/files/16663772/proFileEmulator_Fix2.txt)
[proFileEmulator_Fix1.txt](https://github.com/user-attachments/files/16663774/proFileEmulator_Fix1.txt)

Gary-Clark, 2024-08-24:
Ok, fix 2 worked perfectly 👍 i didn't check the output from the serial terminal as my laptop battery ran out and I had forgot to take the charger, but it works.

System booting into LOS2 from the file you provided, however trying to boot from the LOS3 disk, it throws up a bad checksum error. I shared this image with someone on VCFED (i think they are the creator of the selector) and LOS3 wouldn't boot on their Lisa 2/5 but would on the 2/10 ?

Well chuffed though. The intent is to fit it in the space around the profile without removing any of it so the original disk can be run  when wished and while the selector is a great thing for owners, as a museum piece, booting as it would have in the day is perfect.

Thank you, its greatly appreciated.

Gary-Clark, 2024-09-01:
Hi

Not managed to make any progress but I haven't been able to find a replacement floppy (motor has power but not rotating)

I believe its error 663 but all I remember is a box on initial boot that shows checksum error. Hopefully get back to the machine in a couple of weeks.

alexthecat123, 2024-09-01:
Sounds good! Just let me know when you make some more progress.
