alexthecat123/ArduinoFile/ArduinoFile-Mega-Schematic-v1.0.pdf

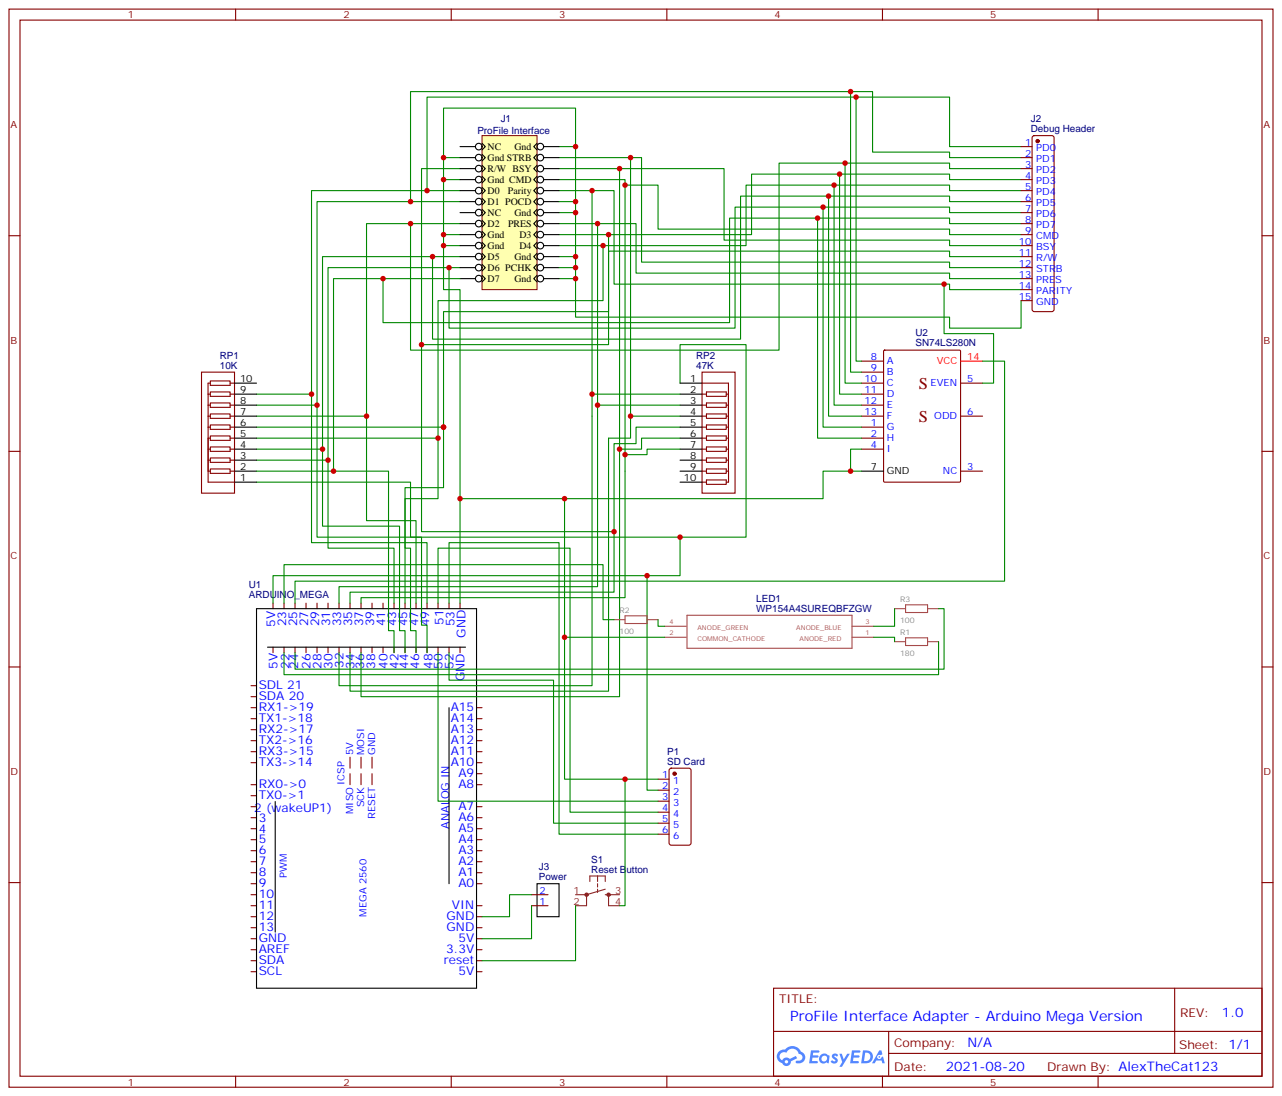
[picture p1: page 1]
