alexthecat123/ArduinoFile/(commit log)

2021-12-15 Updated PCB to a simpler and more compact design.
2021-12-16 Update readme to account for the new PCB design.
2021-12-16 Added support for the status LED.
2022-03-23 Bug fixes and removal of unnecessary code
    Fixed a bug where the ArduinoFile doesn't wait for the host to raise /CMD before checking for an 0x55 on the bus, causing disk errors on some Lisas (but not mine for some reason). Also removed code related to the key-value store for Tom Stepleton's Selector program; after partially implementing it a few months ago, I realized that it would be way too slow on an Arduino and so I just removed it entirely.
    [proFileEmulator.ino]
2022-05-07 Bug fixes and partial key-value implementation
    [proFileEmulator.ino]
2023-11-05 Changed versioning scheme for PCBs and added version to silkscreen.
2023-11-13 Fixed a bug where blocks over 7FFF can't be accessed correctly.
    How the heck did I introduce this bug in the first place? My ArduinoFile works fine with the older version of the code, so I guess I was running a different version of the code than what's on Github or something?
    [proFileEmulator.ino]
2023-11-29 Fixed an LED pin mapping issue.
    [proFileEmulator.ino]
2023-11-29 Fixed the SD card footprint being backwards on the updated board.
2023-11-30 Fixed a bug where blocks over 7FFF can't be accessed correctly.
    [proFileEmulator.ino]
2025-01-21 Made a fix that might improve parallel card compatibility
    [proFileEmulator.ino]
